IoTopenTech/thethingnetwork_madrid_taller_gateway_nodo_single_channel/README.md

# Taller TTNMadrid

- Gateway Mono-canal
  - Compilación verificada con la versión 2.6.2 del gestor de placas ESP8266
  - Compilación verificada con la versión 1.8.10 de Arduino
  - Modelos 3D para la carcasa (sólo piezas amarillas): https://www.tinkercad.com/things/hQr2E4W4Zfp
- Nodo Puerta Abierta
  - Modelos 3D para la carcasa (sólo piezas amarillas): https://www.tinkercad.com/things/ilqWqOo9zD4
