IoTopenTech/thethingnetwork_madrid_taller_gateway_nodo_single_channel/Presentacion/TTN_MADRID_Taller_gateway_nodo_single_channel.pdf

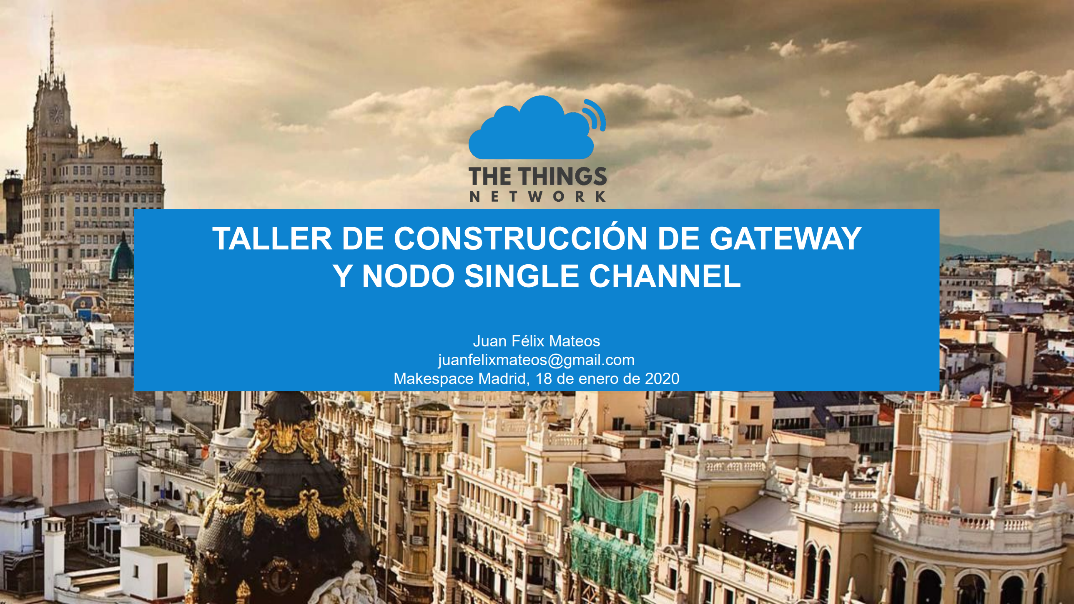
[picture p1: page 1]

TALLER DE CONSTRUCCIÓN DE GATEWAY Y NODO SINGLE CHANNEL

Juan Félix Mateos
juanfelixmateos@gmail.com
Makespace Madrid, 18 de enero de 2020

- Presentación de la comunidad The Things Network Madrid
- Normas básicas de seguridad y técnicas de soldadura
- Construcción del gateway
- Programación del gateway
- Crear una cuenta en The Things Network, alta del gateway, y creación de una aplicación para gestionar el nodo
- Construcción del nodo
- Programación del nodo
- Integración del nodo con IFTTT y Cayenne para recibir notificaciones y SMS en nuestro móvil cada vez que el sensor detecte que se ha abierto la puerta
- Preguntas y sugerencias

PROGRAMACIÓN DEL TALLER

- Divulgación
- Formación
- Asesoramiento
- Implantación

LA COMUNIDAD The Things Network Madrid

Arquitectura de The Things Network
Nodos, aplicaciones, gateways, backend, y aplicaciones

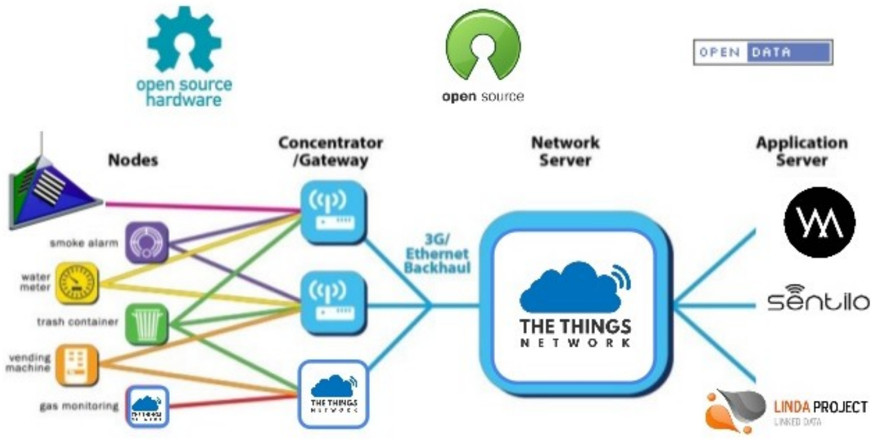
[picture p2: figure]

- Aplicación
- Application EUI
- Application Key
- Nodo (una aplicación puede contar con varios nodos)
- Device EUI
- Activación: OTAA (over the air activation) vs ABP (activation by personalization)
- Device Address
- Network Session Key
- Application Session Key

APLICACIONES Y NODOS

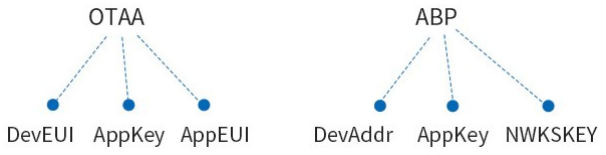
[picture p3: figure]

SEGURIDAD Y SOLDADURA

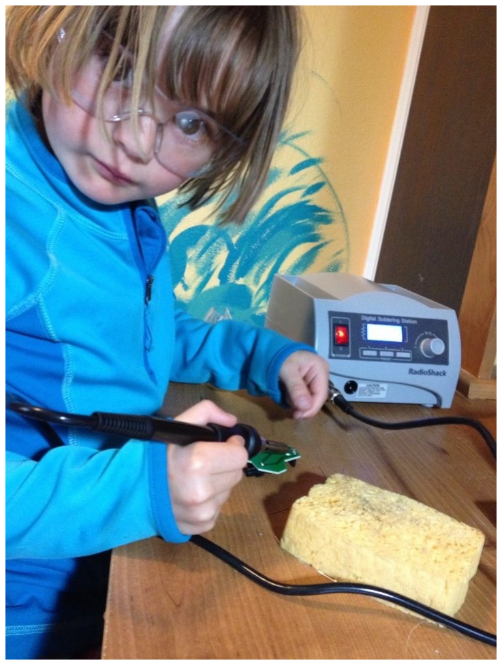
[picture p4: figure]

Riesgos
- Químicos
- Plomo nunca más
- Rosin (Colofonía) ¡Ojo con asmáticos!
- Térmicos
- Quemarse (poca importancia salvo que afecte a los ojos)
- Eléctricos
- Quemar el cable del soldador → Salta el magnetotérmico y susto
- No usar pulseras anti-estáticas → Estorban
- Mecánicos
- Punta del soldador → Pinchar al compañero

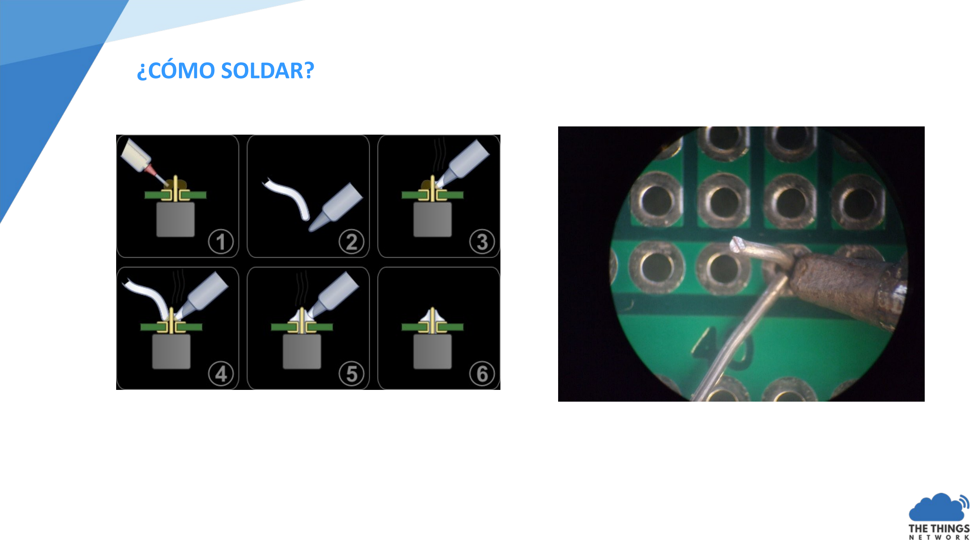
[picture p5: page 7]

¿CÓMO SOLDAR?

SOLDADURA CORRECTA

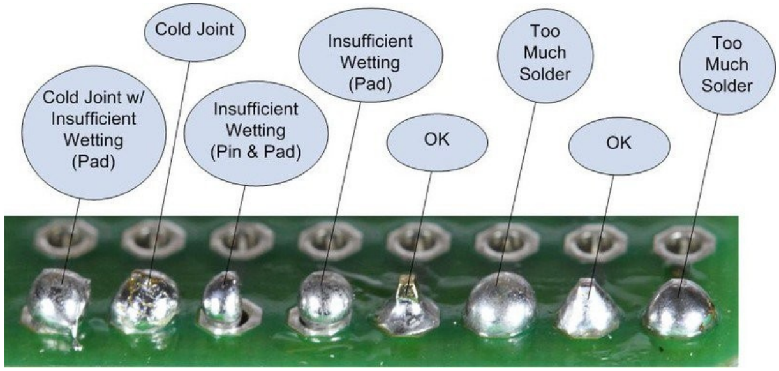
[picture p6: figure]

LISTA DE MATERIALES

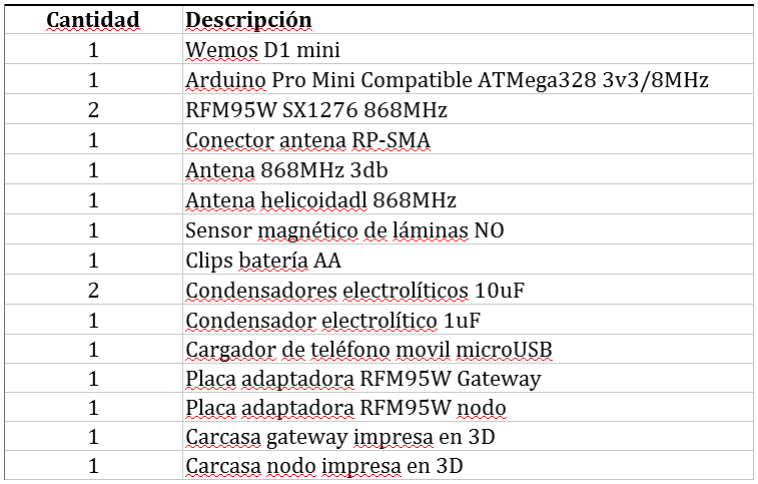
[picture p7: figure]

## - Disponible en el repositorio:

– https://github.com/IoTopenT ech/thethingnetwork_madri d_taller_gateway_nodo_sin gle_channel/blob/master/th ethingnetwork_madrid_talle r_gateway_nodo_single_ch annel_BOM.ods (https://github.com/IoTopenTech/thethingnetwork_madrid_taller_gateway_nodo_single_channel/blob/master/thethingnetwork_madrid_taller_gateway_nodo_single_channel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)

1. Soldar los pines macho-hembra en el wemos dejando el conector microusb del lado de las hembras

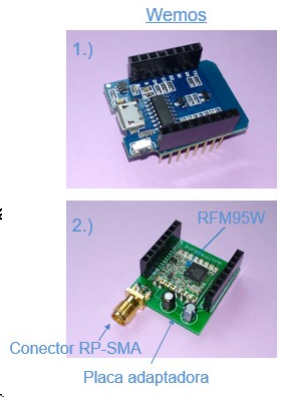
[picture p8: figure]

2. Soldar los componentes de la placa adaptadora del gateway en el siguiente orden:
1. RFM95W
2. Conector RP-SMA
3. Condensadores de 10uF y 100uF (atención a la polaridad). Estos 2 componentes son opcionales.
4. Pines hembra hacia el lado de la cara de componentes

CONSTRUCCIÓN DEL GATEWAY

1. Instalar una versión reciente del entorno de desarrollo Arduino.
- https://www.arduino.cc/en/Main/Software
2. Configurar en el IDE Arduino el gestor de placas ESP8266
- http://arduino.esp8266.com/stable/package_esp8266com_index.json
3. Descargar el repositorio del taller:
- https://github.com/IoTopenTech/thethingnetwork_madrid_taller_gateway_nodo_single_channel

PROGRAMACIÓN DEL GATEWAY
Requisitos previos

4. En el IDE de Arduino, abrir el archivo (se encuentra en el repositorio descargado en el paso 3):
- ESP-1ch-Gateway-v6.0-master\ESP-sc-gway\ESP-sc-gway.ino
5. Seleccionar el archivo configGway.h
6. Introducir la información oportuna en las líneas 226-232 (las coordenadas puedes obtenerse con la opción ¿Qué hay aquí? De Google Maps)

PROGRAMACIÓN DEL GATEWAY
Configuración de la ubicación

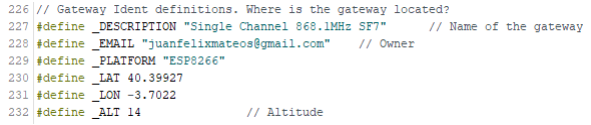
[picture p9: figure]

1. En el archivo configNode.h, introducir la información oportuna a partir de la línea 125 (pueden configurarse varias SSID, pero la línea 126 debe dejarse intacta)

Nota: Esto permite la comunicación entre el Gateway y la red. Los datos enviados por el Nodo serán recogidos por el Gateway y enviados a la consola TTN.

PROGRAMACIÓN DEL GATEWAY
Configuración de las credenciales WiFi

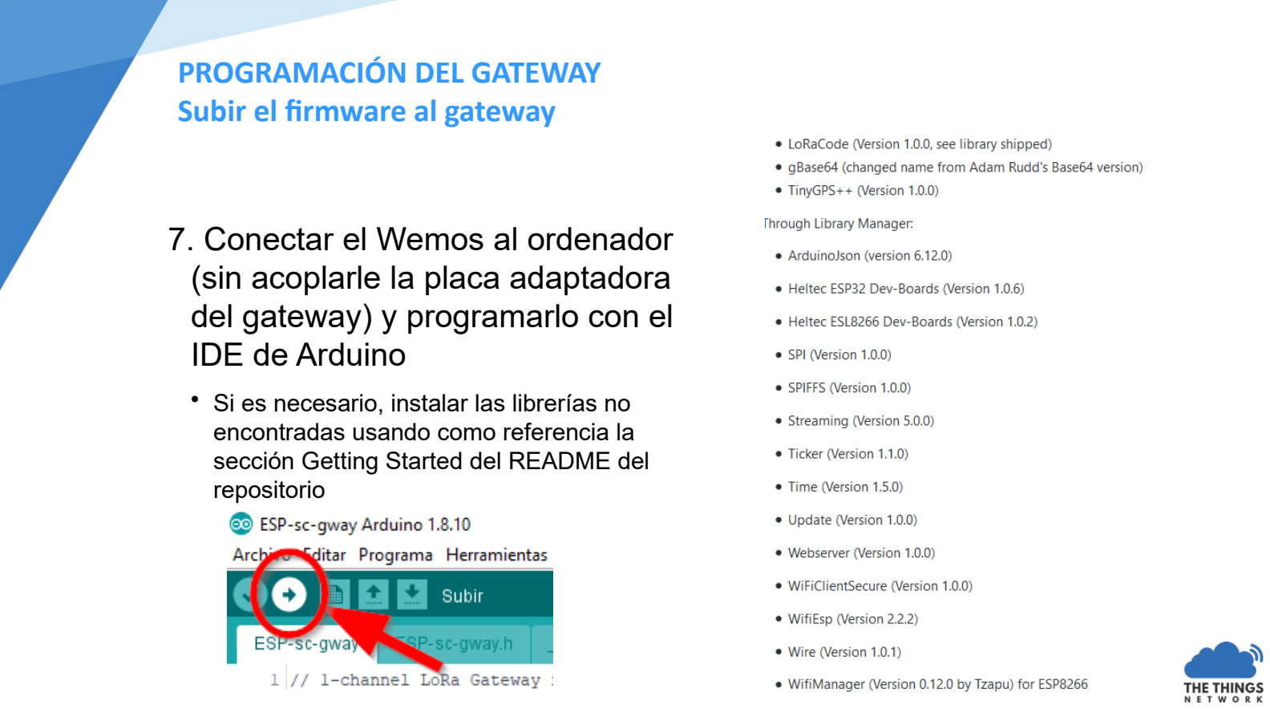
[picture p10: page 14]

7. Conectar el Wemos al ordenador (sin acoplarle la placa adaptadora del gateway) y programarlo con el IDE de Arduino
- Si es necesario, instalar las librerías no encontradas usando como referencia la sección Getting Started del README del repositorio

PROGRAMACIÓN DEL GATEWAY
Subir el firmware al gateway

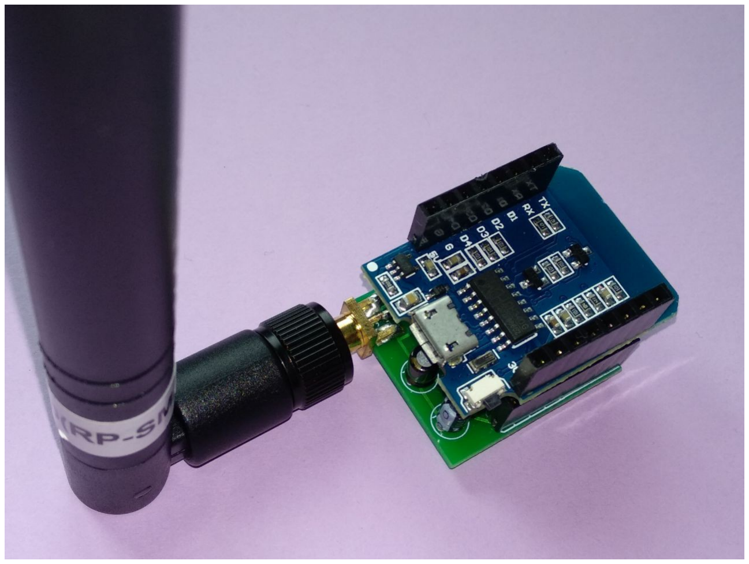
[picture p11: figure]

1. Acopar el wemos y la placa adaptadora (los conectores microusb y RP-SMA quedan
orientados hacia el mismo
lado).
2. Enroscar la antena (nunca debe alimentarse un módulo de radio sin antena; podría
dañarse irreversiblemente)

PROGRAMACIÓN DEL GATEWAY
Montar el gateway

1. Con el gateway conectado al ordenador, abrir el Monitor Serie del IDE de Arduino configurado a 115200 baudios.
2. Tomar nota del Gateway ID (16 dígitos hexadecimales).

PROGRAMACIÓN DEL GATEWAY
Averiguar el Gateway ID

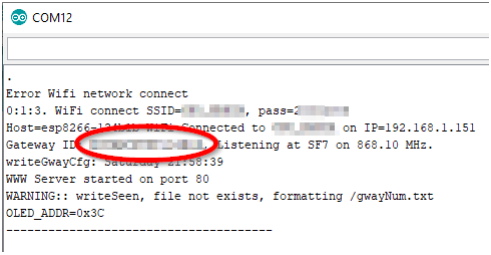
[picture p12: figure]

ALTA DEL GATEWAY EN THE THINGS NETWORK

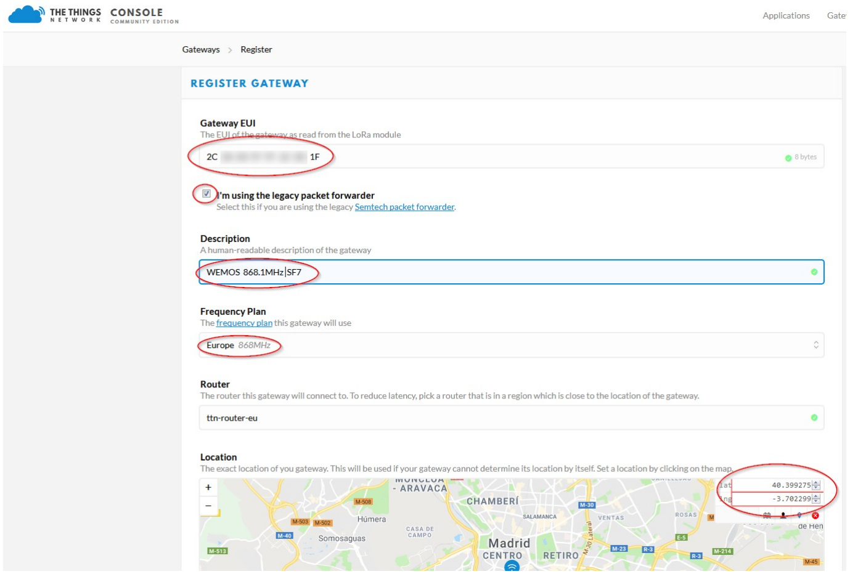
[picture p13: figure]

CREACIÓN DE UNA APLICACIÓN PARA GESTIONAR EL NODO

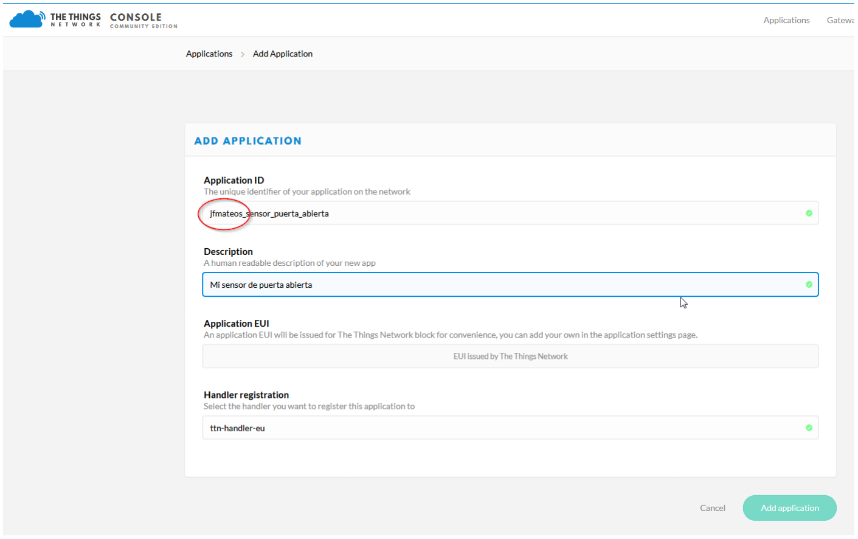
[picture p14: figure]

AÑADIR EL NODO (DEVICE) A LA APLICACIÓN

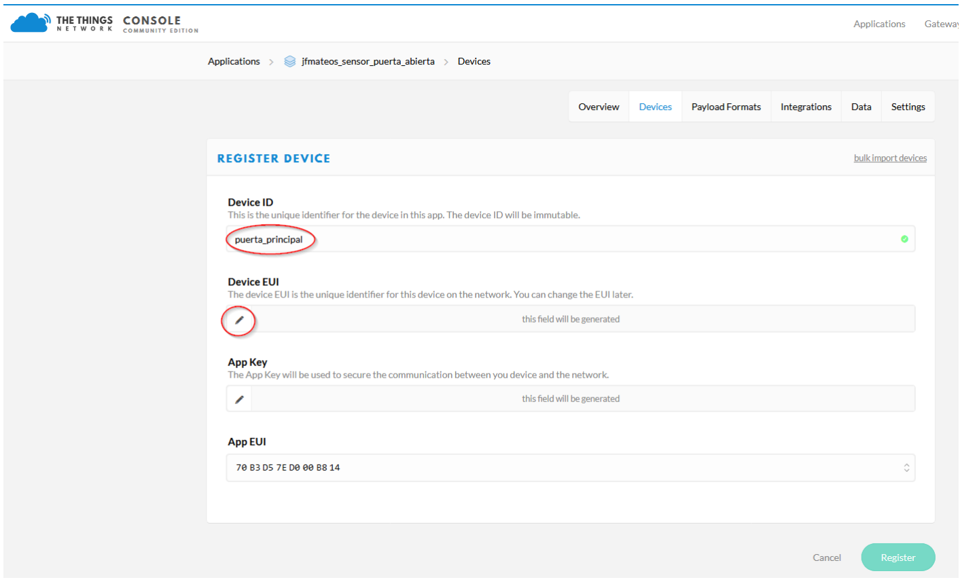
[picture p15: figure]

CAMBIAR EL MÉTODO DE ASOCIÓN A ABP Y DESACTIVAR EL FRAME COUNTER CHECK

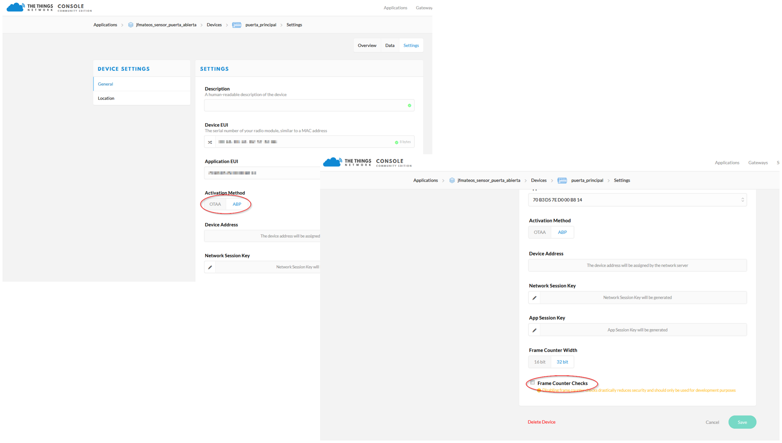
[picture p16: figure]

DATOS NECESARIOS PARA CONECTAR EL NODO

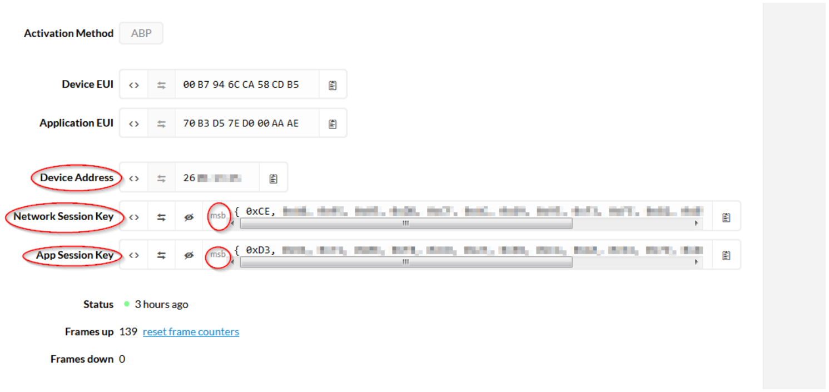
[picture p17: figure]

ESTABLECER EL PAYLOAD FORMAT DE CAYENNE

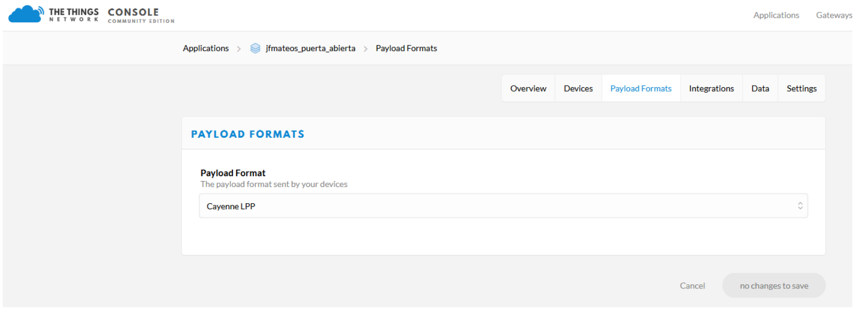
[picture p18: figure]

1.Insertar los pines acodados desde la cara de soldadura y soldarlos por la cara de componentes.
2.Insertar los pines macho desde el lado de la cara de soldadura de la placa tipo Arduino Pro Mini, y soldarlos por el lado de la cara de componentes.
- Evitar dejar restos de estaño en los pines (para poner insertar en ellos cables tipo Dupont si fuera necesario)

CONSTRUCCIÓN DEL NODO
SOLDAR LOS PINES DE LA PLACA TIPO ARDUINO PRO MINI

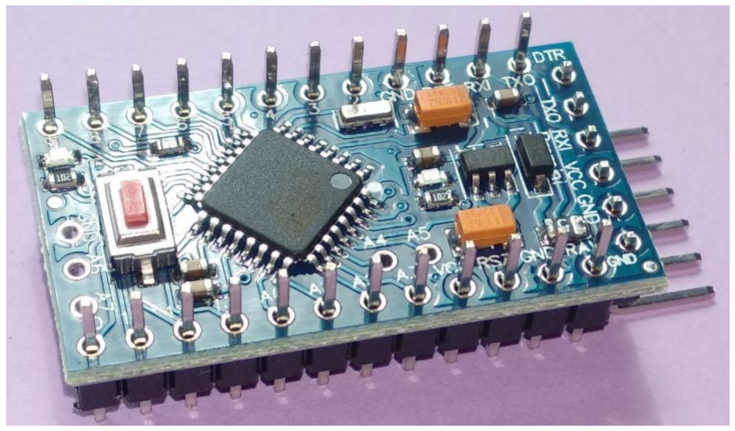
[picture p19: figure]

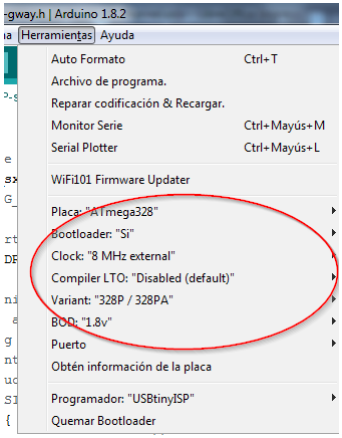
[picture p20: figure]

1. Con el bootloader por defecto, la placa Arduino Pro Mini deja de funcionar cuando el Brown Out Detector (BOD) detecta que la tensión de la batería ha caído por debajo de 2.7V. Cambiando al bootloader MiniCore podemos configurar una tensión BOD de 1.8V. Añadir el gestor de placas MiniCore (separarlo con una coma del de ESP8266 en Preferencias):
- https://mcudude.github.io/MiniCore/package_MCUdude_MiniCore_index.json
2. Configurar la placa como se muestra en la imagen.
3. Quemar el nuevo bootloader usando un programador tipo USBTinyISP

CONSTRUCCIÓN DEL NODO
Sustituir el bootloader por MiniCore (opcional)

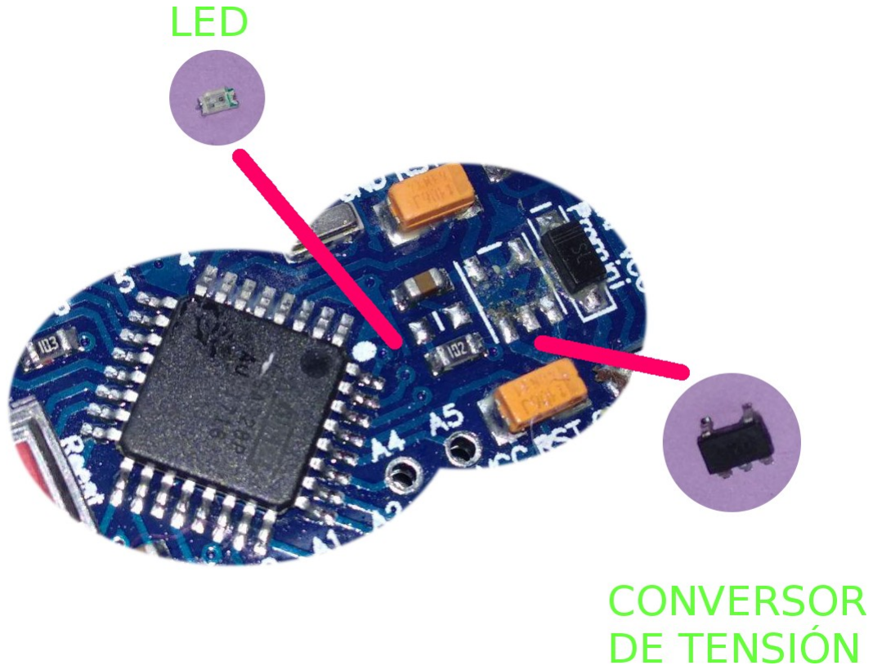
[picture p21: figure]

1. Si eliminamos de la placa tipo Arduino Pro Mini el LED y el conversor de tensión conseguiremos reducir el consumo en estado Power Down Sleep de 900uA a 4.5uA, con lo que se extiende enormemente la duración de las baterías.
- Utilizar el soldador de aire caliente para eliminar el LED y el conversor de tensión.

CONSTRUCCIÓN DEL NODO
Configurarlo para bajo consumo de energía (opcional)

1. Abrir en el IDE de Arduino el archivo Nodo\ lora_mini_node_ttn_madrid_abp_puerta_abierta\ lora_mini_node_ttn_madrid_abp_puerta_abierta.ino.
2. Insertar los datos de conexión en las líneas 47, 52 y 55.
3.Programar el nodo usando un conversor USB → Serial.

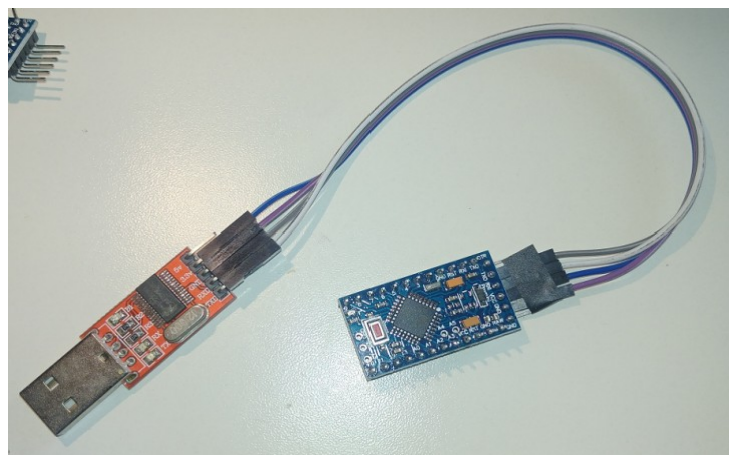
[picture p22: figure]

- Según el USB Serial es necesario presionar el botón rojo del Arduino Pro Mini hasta que su estado en el IDE esté en “subiendo” y soltar

PROGRAMACIÓN DEL NODO

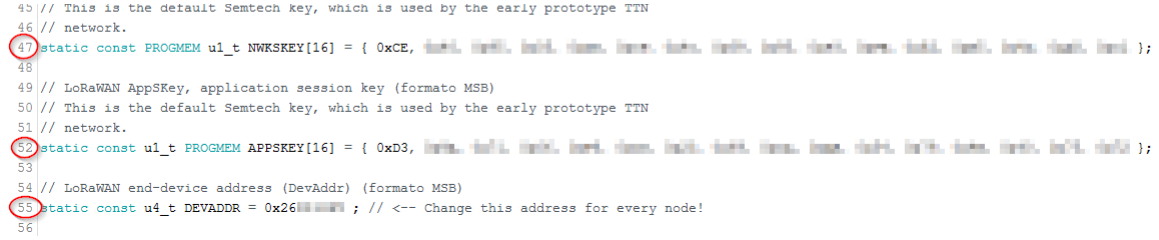
[picture p23: figure]

1. Soldar los componentes de la placa adaptadora del nodo en el siguiente orden:
1. RFM95W
2. Antena helicoidal
3.Condensador de 10uF (opcional)
4. Pines GND y 3v3
5. Placa tipo Arduino Pro Mini
6. Cables del sensor reed en los pines 3 y GND, o
en las posiciones adyacentes a la entrada de alimentación (paso siguiente).
7. Cables para el portabaterías en los pines GND y 3V3
2. Montar el portabaterías

TERMINAR EL NODO

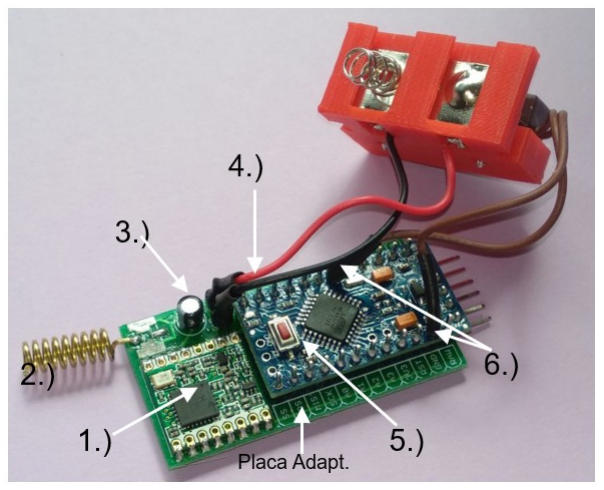
[picture p24: figure]
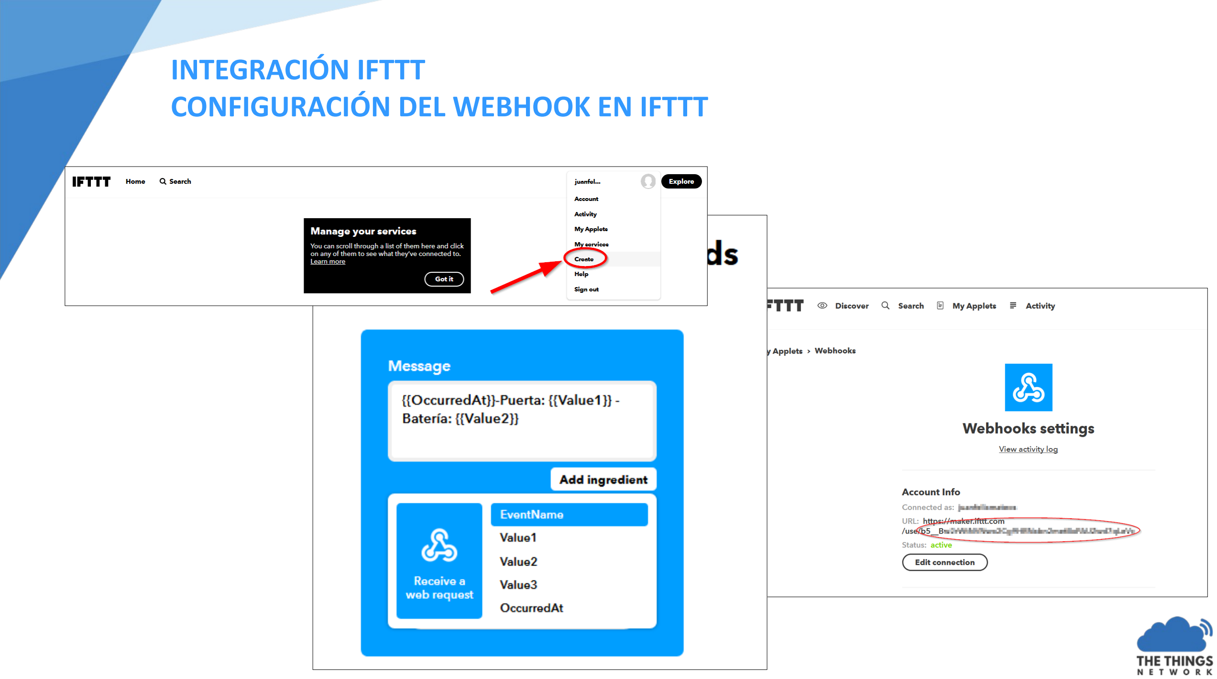
[picture p25: page 28]

INTEGRACIÓN IFTTT
CONFIGURACIÓN DEL WEBHOOK EN IFTTT

INTEGRACIÓN IFTTT
CONFIGURACIÓN EN THE THINGS NETWORK

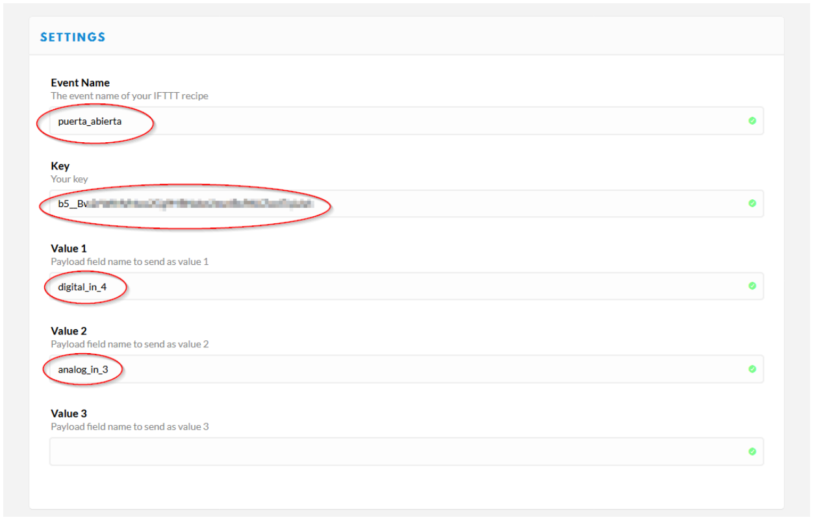
[picture p26: figure]
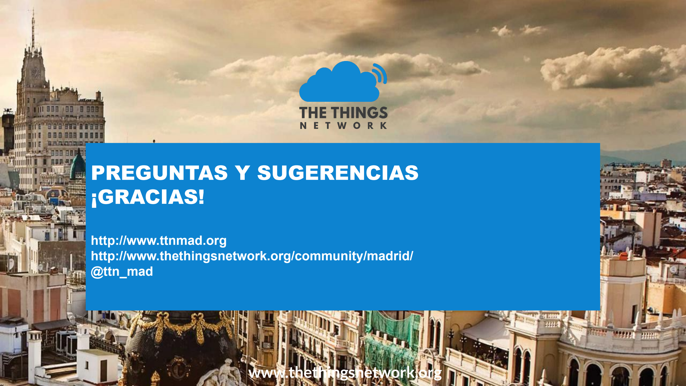
[picture p27: page 30]

## PREGUNTAS Y SUGERENCIAS ¡GRACIAS!

http://www.ttnmad.org
http://www.thethingsnetwork.org/community/madrid/@ttn_mad

www.thethingsnetwork.org
