IoTopenTech/thethingnetwork_madrid_taller_gateway_nodo_single_channel/Nodo/README.md

# Taller TTNMadrid

- En la carpeta Libraries puede encontrar las librerías necesarias para compilar este proyecto.
