IoTopenTech/thethingnetwork_madrid_taller_gateway_nodo_single_channel/thethingnetwork_madrid_taller_gateway_nodo_single_channel_BOM.ods

Materiales para el taller de TheThingsNetwork Madrid de construcción de un gateway y nodo single-channel configurado como sensor de puerta abierta
Cantidad | Descripción | Dónde conseguirlo
1 | Wemos D1 mini | https://es.aliexpress.com/item/10-sets-D1-Mini-nodemcu-4-m-bytes-Luna-esp8266-WiFi-Internet-de-cosas-basado-en/32838136418.html
1 | Arduino Pro Mini Compatible ATMega328 3v3/8MHz | https://es.aliexpress.com/item/10PCS-3-3V-12V-DC-ATMEGA328P-Pro-Mini-328-Mini-ATMEGA328-3-3V-8M-for-Arduino/32811814896.html
2 | RFM95W SX1276 868MHz | https://es.aliexpress.com/item/RFM95W-RFM95-868MHz-LORA-SX1276-wireless-transceiver-module-20DBM-3KM-Best-quality/32810607598.html
1 | Conector antena RP-SMA | https://es.rs-online.com/web/p/conectores-sma/1258192
1 | Antena 868MHz 3db | https://es.aliexpress.com/item/10pcs-lot-868-mhz-Aerial-868Mhz-WHIP-ANTENNA-for-RADIO-FREQUENCY-with3-dB-Gain-TX-RX/32811151712.html
1 | Antena helicoidadl 868MHz | https://www.ebay.es/itm/10pcs-Copper-13mm-868MHz-50-Spring-Antenna-for-Wireless-Communication-System/172301237099
1 | Sensor magnético de láminas NO | https://es.aliexpress.com/item/10pcs-normally-open-NO-Wired-Door-Window-Sensor-Magnetic-Switch-Home-Alarm-System-for-gsm-pstn/32844860501.html
1 | Clips batería AA | https://es.aliexpress.com/item/200-unids-bater-a-metralla-bater-a-AA-hoja-primavera-contacto-12-12mm-positivo-y-negativo/32840333042.html
2 | Condensadores electrolíticos 10uF | https://www.mouser.es/ProductDetail/647-UMA1C100MDD1TP?r=647-UMA1C100MDD1TP
1 | Condensador electrolítico 1uF | https://www.mouser.es/ProductDetail/Nichicon/UMF1V010MDD1TP
1 | Cargador de teléfono movil microUSB | Puedes usar cualquiera que tengas de sobra. Lo usamos para alimentar el gateway, que está permanentemente conectado, por lo que conviene que tenga una calidad aceptable.
1 | Placa adaptadora RFM95W Gateway | Pásate por uno de nuestros eventos y te la regalamos si nos avisas con antelación o (https://github.com/jfmateos/thethingnetwork_madrid_taller_gateway_nodo_single_channel/tree/master/Gateway/PCB_placa_adaptadora)
1 | Placa adaptadora RFM95W nodo | Pásate por uno de nuestros eventos y te la regalamos si nos avisas con antelación o (https://github.com/jfmateos/thethingnetwork_madrid_taller_gateway_nodo_single_channel/tree/master/Nodo/PCB_placa_adaptadora)
1 | Carcasa gateway impresa en 3D | Piezas de color amarillo de https://www.tinkercad.com/things/hQr2E4W4Zfp
1 | Carcasa nodo impresa en 3D | Piezas de color amarillo de https://www.tinkercad.com/things/ilqWqOo9zD4
