IoTopenTech/thethingnetwork_madrid_taller_gateway_nodo_single_channel/Gateway/PCB_placa_adaptadora/WeMos-Lora.brd

## EAGLE design Gateway/PCB_placa_adaptadora/WeMos-Lora.brd (2020-01-19)

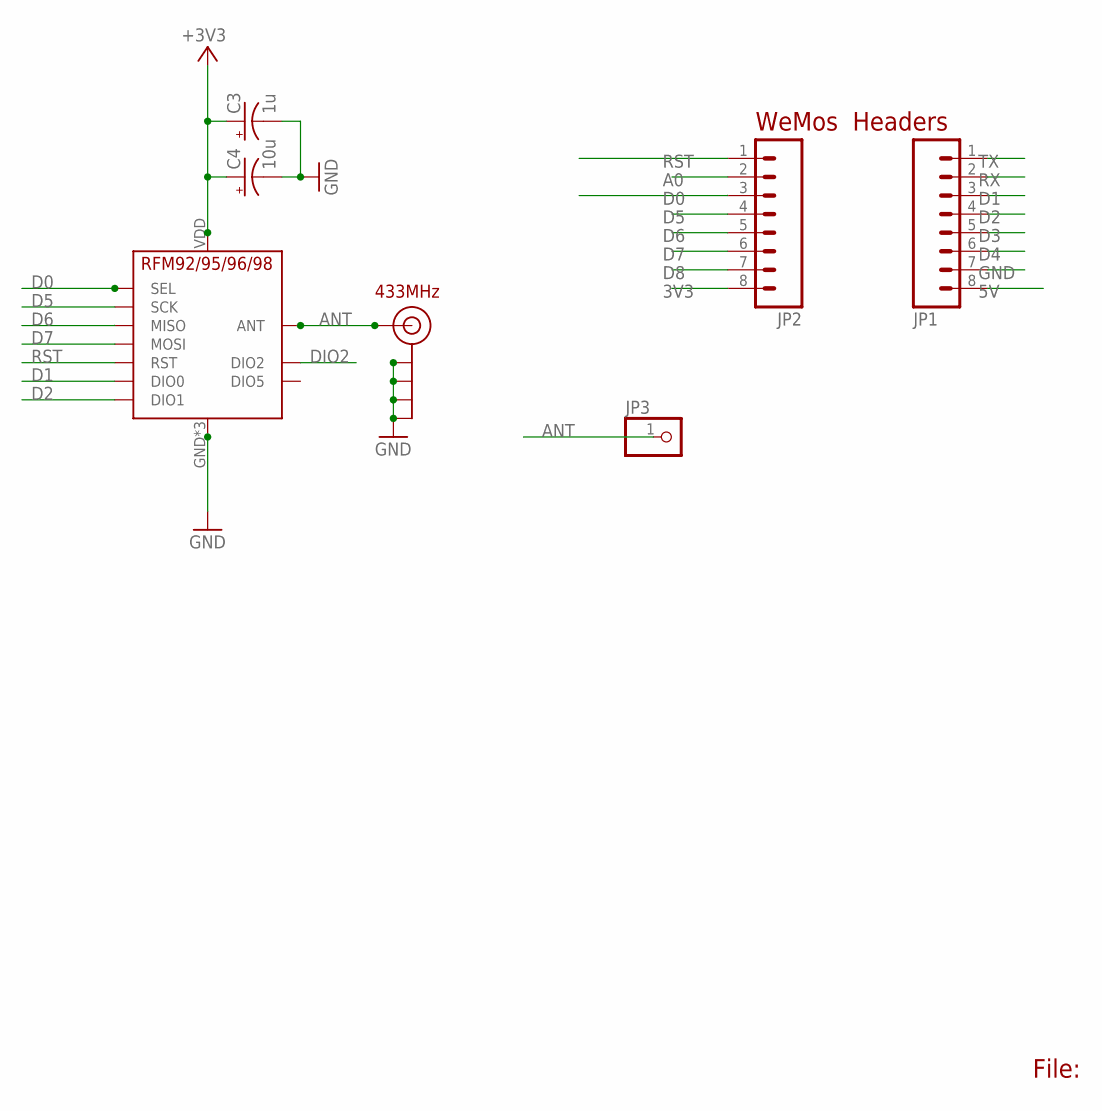
[picture p28: schematic WeMos-Lora.sch]

Parts:
C3: 1u; CPOL-RADIAL-10UF-25V
C4: 10u; CPOL-RADIAL-10UF-25V
J$2: ANTENNATINY; SMA_UFL_PAD_TINY
JP1, JP2: M08NO_SILK_FEMALE_PTH; 1X08_NO_SILK
JP3: PINHD-1X1; 1X01
U$5: RFM95

Connections:
3V3: C3.1 (+), C4.1 (+), JP2.8, U$5.VDD (VCC)
5V: JP1.8
A0: JP2.2
ANT: J$2.ANT1 (SIGNAL), J$2.ANT2 (SIGNAL), J$2.ANT3 (SIGNAL), JP3.1, U$5.ANT
D0: JP2.3, U$5.NSS (SEL)
D1: JP1.3, U$5.DIO0
D2: JP1.4, U$5.DIO1
D3: JP1.5
D4: JP1.6
D5: JP2.4, U$5.SCK
D6: JP2.5, U$5.MISO
D7: JP2.6, U$5.MOSI
D8: JP2.7
DIO2: U$5.DIO2
GND: C3.2 (-), C4.2 (-), J$2.GND1 (GND), J$2.GND2 (GND), J$2.GND3 (GND), J$2.GND4 (GND), JP1.7, U$5.GND, U$5.GND1 (GND), U$5.GND2 (GND)
RST: JP2.1, U$5.RST
RX: JP1.2
TX: JP1.1

Notes on the sheet:
File:
WeMos Headers
433MHz

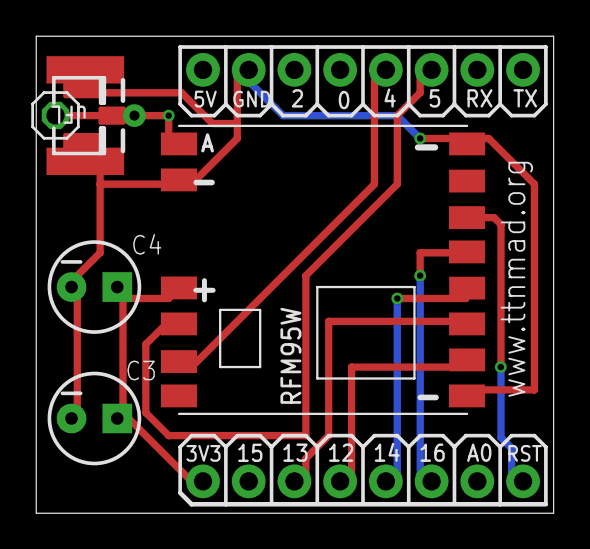
[picture p29: board WeMos-Lora.brd from above]

Board: 2 copper layers, 28.7 x 26.5 mm, 7 parts (0 on the bottom side), 10 nets.
