IoTopenTech/thethingnetwork_madrid_taller_gateway_nodo_single_channel/Nodo/PCB_placa_adaptadora/Mini-Lora.brd

## EAGLE design Nodo/PCB_placa_adaptadora/Mini-Lora.brd (2020-01-18)

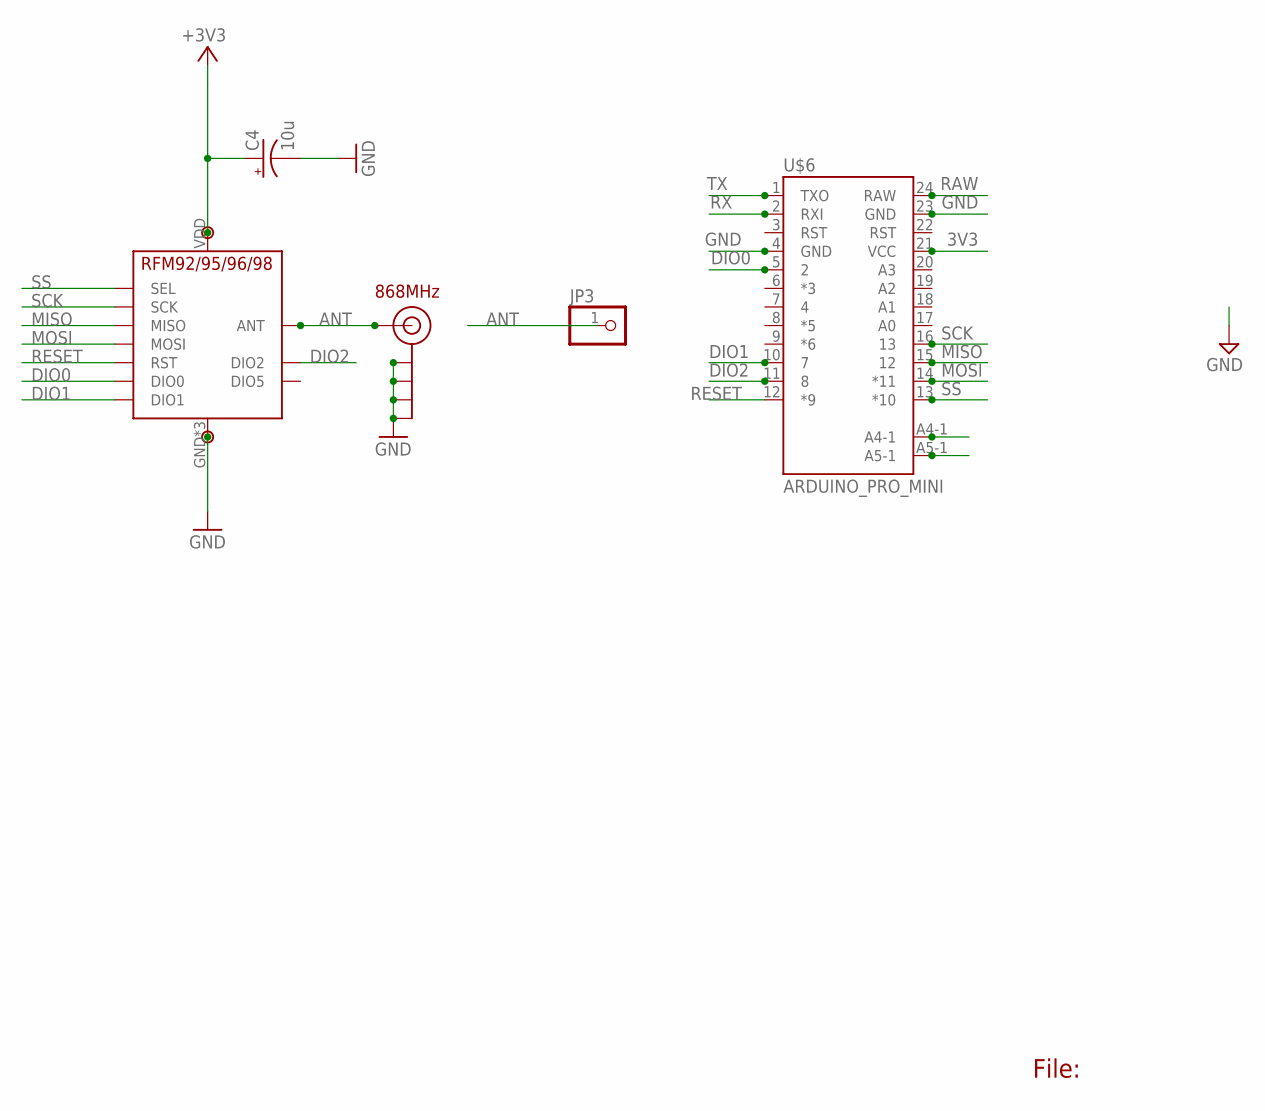
[picture p30: schematic Mini-Lora.sch]

Parts:
C4: 10u; CPOL-RADIAL-10UF-25V
J$2: ANTENNATINY; SMA_UFL_PAD_TINY
JP3: PINHD-1X1; 1X01
P1: GND; PAD
P2: 3v3; PAD
U$5: RFM95
U$6: ARDUINO_PRO_MINI

Connections:
3V3: C4.1 (+), P2.1, U$5.VDD (VCC), U$6.21 (VCC)
ANT: J$2.ANT1 (SIGNAL), J$2.ANT2 (SIGNAL), J$2.ANT3 (SIGNAL), JP3.1, U$5.ANT
DIO0: U$5.DIO0, U$6.5 (2)
DIO1: U$5.DIO1, U$6.10 (7)
DIO2: U$5.DIO2, U$6.11 (8)
GND: C4.2 (-), J$2.GND1 (GND), J$2.GND2 (GND), J$2.GND3 (GND), J$2.GND4 (GND), P1.1, U$5.GND, U$5.GND1 (GND), U$5.GND2 (GND), U$6.4 (GND), U$6.23 (GND)
MISO: U$5.MISO, U$6.15 (12)
MOSI: U$5.MOSI, U$6.14 (*11)
RAW: U$6.24 (RAW)
RESET: U$5.RST, U$6.12 (*9)
RX: U$6.2 (RXI)
SCK: U$5.SCK, U$6.16 (13)
SCL: U$6.A5-1
SDA: U$6.A4-1
SS: U$5.NSS (SEL), U$6.13 (*10)
TX: U$6.1 (TXO)

Notes on the sheet:
File:
868MHz

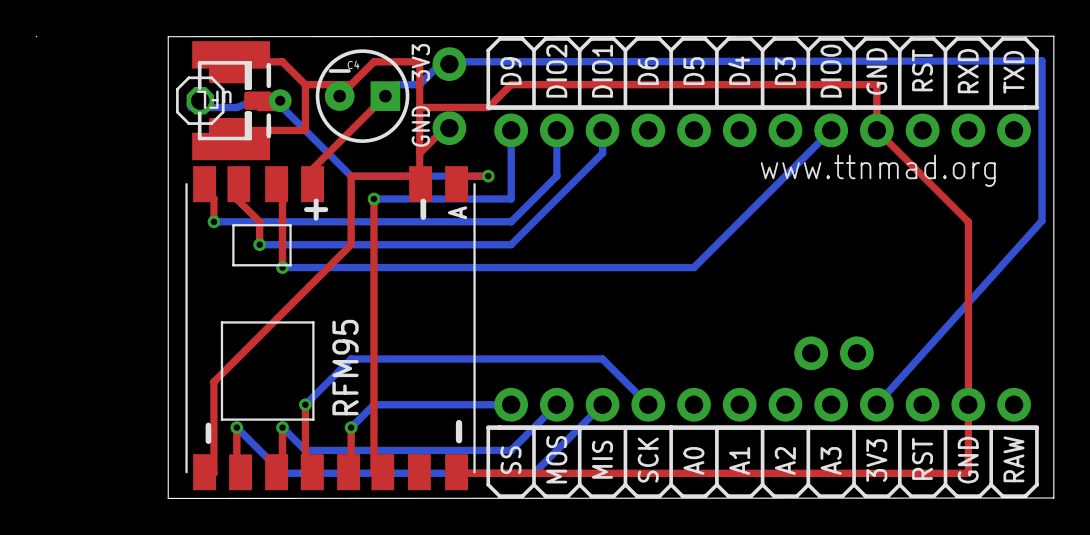
[picture p31: board Mini-Lora.brd from above]

Board: 2 copper layers, 49.2 x 25.7 mm, 7 parts (0 on the bottom side), 11 nets.
