IoTopenTech/thethingnetwork_madrid_taller_gateway_nodo_single_channel/(commit log)

2020-01-18 Primer envio
    [Mini-Lora.brd, Mini-Lora.sch, thethingnetwork_madrid_taller_gateway_nodo_single_channel_BOM.ods]
2020-01-18 Actualizado hasta el gateway
