IoTopenTech/thethingnetwork_madrid_taller_gateway_nodo_single_channel/(notices)

Notices in the files:
parts and their libraries:
SparkFun-Aesthetics: Licensing: Creative Commons ShareAlike 4.0 International - https://creativecommons.org/licenses/by-sa/4.0
